JLjoestar23/STM32_FlightController/README.md

# STM32_FlightController
PCB, software, firmware, and other files related to a custom made STM32-based flight controller.
