JLjoestar23/STM32_FlightController/misc/ComponentsBOM.xlsx

Sheet: Electronic Parts
PART NUMBER | PART NAME | DESCRIPTION | QUANTITY | SUPPLIER / MANUFACTURER | UNIT COST | TOTAL PART COST | PURCHASED
C1 | GRM188C71A475KE11D | 4.7uF 0603 SMD Ceramic Capacitor | 10 | https://www.digikey.com/en/products/detail/murata-electronics/GRM188C71A475KE11D/4905309 | $0.1300 | $1.30 | TRUE
C2,C3,C4,C5,C6,C10,C11,C12,C15,C16,C17,C23 | CC0402KRX7R7BB104 | 100nF 0402 SMD Ceramic Capacitor | 60 | https://www.digikey.com/en/products/detail/yageo/CC0402KRX7R7BB104/2103076 | $0.0143 | $0.86 | TRUE
C7 | CC0402KRX7R9BB103 | 10nF 0402 SMD Ceramic Capacitor | 10 | https://www.digikey.com/en/products/detail/yageo/CC0402KRX7R9BB103/2103087 | $0.0090 | $0.09 | TRUE
C8,C9,C18 | CC0402KRX5R5BB105 | 1uF 0402 SMD Ceramic Capacitor | 30 | https://www.digikey.com/en/products/detail/yageo/CC0402KRX5R5BB105/2833603 | $0.0540 | $1.62 | TRUE
C13,C14 | GRM188R71A225KE15J | 2.2uF 0603 SMD Ceramic Capacitor | 20 | https://www.digikey.com/en/products/detail/murata-electronics/GRM188R71A225KE15J/2612462 | $0.0850 | $1.70 | TRUE
C19,C20 | GRM21BC81C226ME44L | 22uF 0805 SMD Ceramic Capacitor | 10 | https://www.digikey.com/en/products/detail/murata-electronics/GRM21BC81C226ME44L/4905510 | $0.2780 | $2.78 | TRUE
C21,C22 | GJM1555C1H140GB01D | 14pF 0402 SMD Ceramic Capacitor | 20 | https://www.digikey.com/en/products/detail/murata-electronics/GJM1555C1H140GB01D/6606072 | $0.0690 | $1.38 | TRUE
D1 | PMEG2005CT,215 | Diode Array/Power Mux | 5 | https://www.digikey.com/en/products/detail/nexperia-usa-inc/PMEG2005CT-215/2119859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 | $0.1050 | $0.53 | TRUE
D2 | LTST-C193KRKT-5A | RED LED | 5 | https://www.digikey.com/en/products/detail/liteon/LTST-C193KRKT-5A/2356244 | $0.1360 | $0.68 | TRUE
FB1 | BLM18PG121SN1D | 100Ω @ 120MHz 0603 SMD Ferrite Bead | 10 | https://www.digikey.com/en/products/detail/murata-electronics/BLM18PG121SN1D/584248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 | $0.0600 | $0.60 | TRUE
J1 | USB Micro-B Wuerth 629105150521 | Micro USB Connector | 2 | https://www.digikey.com/en/products/detail/w%C3%BCrth-elektronik/629105150521/5047751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 | $2.2100 | $4.42 | TRUE
J2 | SM08B-SRSS-TB(LF)(SN) | 1x8 Horizontal SMT JST-SH connector | 2 | https://www.digikey.com/en/products/detail/jst-sales-america-inc/SM08B-SRSS-TB/926714 | $0.7800 | $1.56 | TRUE
J3,J4 | SM04B-SRSS-TB(LF)(SN) | 1x4 Horizontal SMT JST-SH connector | 8 | https://www.chip1stop.com/USA/en/products/J.S.T.-MFG/SM04B-SRSS-TB%28LF%29%28SN%29/JST1*0004445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 | $0.5840 | $4.67 | TRUE
J5 | GRPB052VWVN-RC | 2x5 Vertical 1.27mm Pin Header | 2 | https://www.digikey.com/en/products/detail/sullins-connector-solutions/GRPB052VWVN-RC/1786455 | $0.6100 | $1.22 | TRUE
R1,R6 | RC0402JR-073K3L | 3.3kΩ 0402 SMD Resistor | 20 | https://www.digikey.com/en/products/detail/yageo/RC0402JR-073K3L/726456 | $0.0070 | $0.14 | TRUE
R2,R3,R4,R7 | RC0402FR-072K7L | 2.7kΩ 0402 SMD Resistor | 40 | https://www.digikey.com/en/products/detail/yageo/RC0402FR-072K7L/726556 | $0.0080 | $0.32 | TRUE
R5,R8,R10 | RC0402JR-0710KL | 10kΩ 0402 SMD Resistor | 30 | https://www.digikey.com/en/products/detail/yageo/RC0402JR-0710KL/726418 | $0.0070 | $0.21 | TRUE
R9 | RC0402JR-071K5L | 1.5kΩ 0402 SMD Resistor | 10 | https://www.digikey.com/en/products/detail/yageo/RC0402JR-071K5L/726412 | $0.0070 | $0.07 | TRUE
SW1 | PTS815SJM250SMTRLFS | Tactile Switch Button | 5 | https://www.digikey.com/en/products/detail/c-k/PTS815SJM250SMTRLFS/9947846 | $0.2200 | $1.10 | TRUE
SW2 | PCM12SMTR | Tactile 2 Way Switch | 2 | https://www.digikey.com/en/products/detail/c-k/PCM12SMTR/1640112 | $1.1400 | $2.28 | TRUE
U1,U8 | SN74LVC1T45DBVR | 3.3V - 1.8V Logic Level Shifter | 10 | https://www.digikey.com/en/products/detail/texas-instruments/SN74LVC1T45DBVR/639455 | $0.2910 | $2.91 | TRUE
U2 | ICM-20948 | 9 Axis IMU | 2 | https://www.digikey.com/en/products/detail/tdk-invensense/ICM-20948/6623535 | $6.7800 | $13.56 | TRUE
U3 | STM32F405RGT6 | Microcontroller Unit | 2 | https://www.digikey.com/en/products/detail/stmicroelectronics/STM32F405RGT6/2754208 | $11.1400 | $22.28 | TRUE
U4 | USBLC6-2SC6 | ESD Protection for USB | 5 | https://www.digikey.com/en/products/detail/stmicroelectronics/USBLC6-2SC6/1040559 | $0.3600 | $1.80 | TRUE
U5 | AMS1117-3.3 | 5V - 3.3V Low-Dropout Regulator | 5 | https://www.digikey.com/en/products/detail/evvo/AMS1117-3-3/22482148 | $0.2700 | $1.35 | TRUE
U6 | TLV70018 | 3.3V - 1.8V Low-Dropout Regulator | 5 | https://www.digikey.com/en/products/detail/texas-instruments/TLV70018DDCR/2232568 | $0.2000 | $1.00 | TRUE
U7 | BMP390 | Barometric Pressure Sensor | 2 | https://www.digikey.com/en/products/detail/bosch-sensortec/BMP390/16164575 | $3.1500 | $6.30 | TRUE
Y1 | X32258MOB4SI | 8MHz Crystal | 5 | https://lcsc.com/product-detail/Crystals_Yangxing-Tech-X32258MOB4SI_C2682775.html | $0.1649 | $0.82 | TRUE
 |  | TOTAL PARTS | 337 |  | TOTAL | $77.55

Sheet: General BOM
PART NAME | DESCRIPTION | QUANTITY | SUPPLIER / MANUFACTURER | UNIT COST | TOTAL PART COST | PURCHASED
RP1 V2 ExpressLRS 2.4ghz Nano Receiver | ELRS Receiver | 1 | https://www.radiomasterrc.com/products/rp1-expresslrs-2-4ghz-nano-receiver?variant=46464159908071 | $18.99 | $18.99 | FALSE
XRotor FPV 30x30 ESC 65A | 4 in 1 ESC | 1 | https://www.hobbywingdirect.com/collections/xrotor-fpv-30x30-esc/products/xrotor-fpv-30x30-esc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 | $99.99 | $99.99 | FALSE
Mark 4 7inch 295mm 2807 1300KV Brushless Motor 7040 Propeller for Mark4 FPV Racing Drone Quadcopter Freestyle Frame Kit | 7" Drone Frame Kit | 1 | https://www.aliexpress.us/item/3256808893088782.html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 | $29.89 | $29.89 | FALSE
8pcs HQProp 7X3.5X3 7 Inch 3-Blade Propellers Set (4X CW / 4X CCW) Poly Carbonate | Propellors | 1 | https://www.amazon.com/HQProp-7X3-5X3-3-Blade-Propellers-Carbonate/dp/B0CTY33T4G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 | $19.99 | $19.99 | FALSE
Boxer Radio Controller (M2) | Radio Transmitter | 1 | https://www.radiomasterrc.com/collections/transmitter/products/boxer-radio-controller-m2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 | $139.99 | $139.99 | FALSE
 |  |  |  |  | $0.00 | FALSE
 |  |  |  |  | $0.00 | FALSE
 |  |  |  |  | $0.00 | FALSE
 |  |  |  |  | $0.00 | FALSE
 |  |  |  |  | $0.00 | FALSE
 |  |  |  |  | $0.00 | FALSE
 |  |  |  |  | $0.00 | FALSE
 |  |  |  |  | $0.00 | FALSE
 |  |  |  |  | $0.00 | FALSE
 |  |  |  |  | $0.00 | FALSE
 |  |  |  |  | $0.00 | FALSE
 |  |  |  |  | $0.00 | FALSE
 |  |  |  |  | $0.00 | FALSE
 |  |  |  |  | $0.00 | FALSE
 |  |  |  |  | $0.00 | FALSE
 |  |  |  |  | $0.00 | FALSE
 |  |  |  |  | $0.00 | FALSE
 |  |  |  |  | $0.00 | FALSE
 |  |  |  |  | $0.00 | FALSE
 |  |  |  |  | $0.00 | FALSE
 |  |  |  |  | $0.00 | FALSE
 |  |  |  |  | $0.00 | FALSE
 |  |  |  |  | $0.00 | FALSE
 | TOTAL PARTS | 5 |  | TOTAL | $308.85
