JLjoestar23/STM32_FlightController/misc/various_handcalcs.xlsx

Sheet: Current Draw Calcs
Component | Typical Current Draw (mA) | Total Current Draw (mA) | Buffer
STM32F405RGT6 + Peripherals | 120 | 225 | 25%
BMP390 | 1
ICM 20948 | 4 | Total Current Draw w/ Buffer
Adafruit Ultimate GPS Breakout | 20 | 281.25
RP1 Receiver | 80

Sheet: Impedance Matching
Geomtery:
w
d
t
h
