JLjoestar23/STM32_FlightController/STM32_FlightController_Rev2/Footprints-Symbols-Models/BMP390L/BMP390L.step

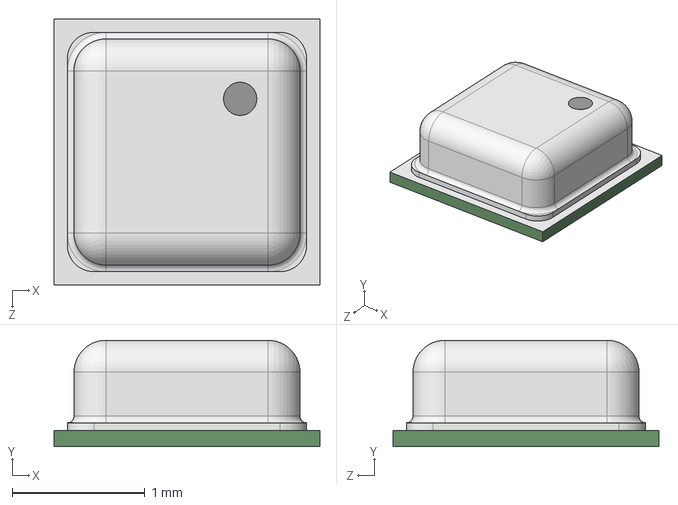
[picture p1: CAD file, 2025-05-25]
STM32_FlightController_Rev2/Footprints-Symbols-Models/BMP390L/BMP390L.step
2.00 x 0.8 x 2.00 mm
