JLjoestar23/STM32_FlightController/STM32_FlightController_Rev2/Footprints-Symbols-Models/SM04B-SRSS-TB.STEP

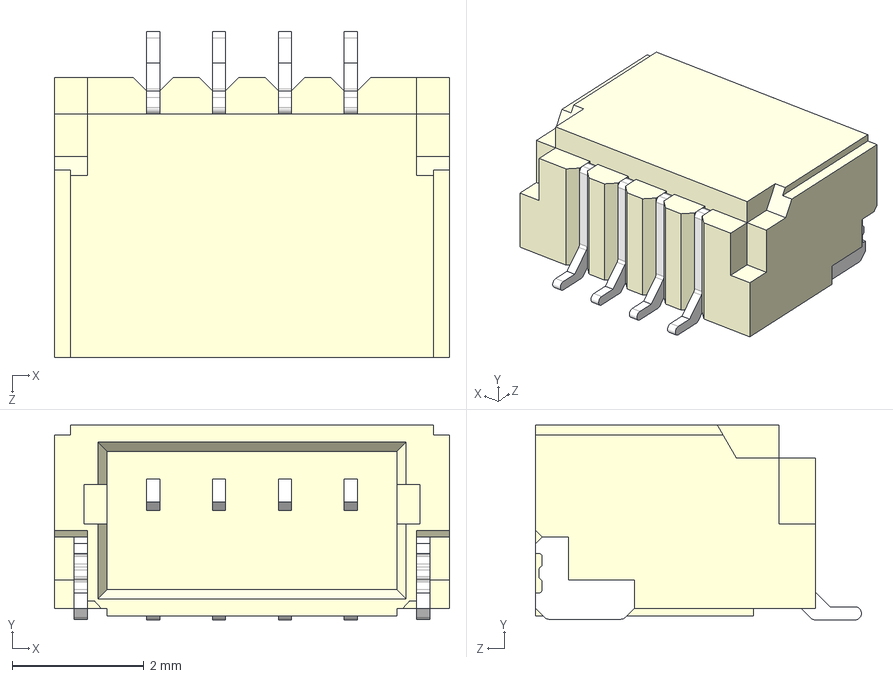
[picture p2: CAD file, 2025-06-05]
STM32_FlightController_Rev2/Footprints-Symbols-Models/SM04B-SRSS-TB.STEP
6.00 x 2.96 x 4.95 mm
