JLjoestar23/STM32_FlightController/STM32_FlightController_Rev2/Footprints-Symbols-Models/SM08B-SRSS-TB.step

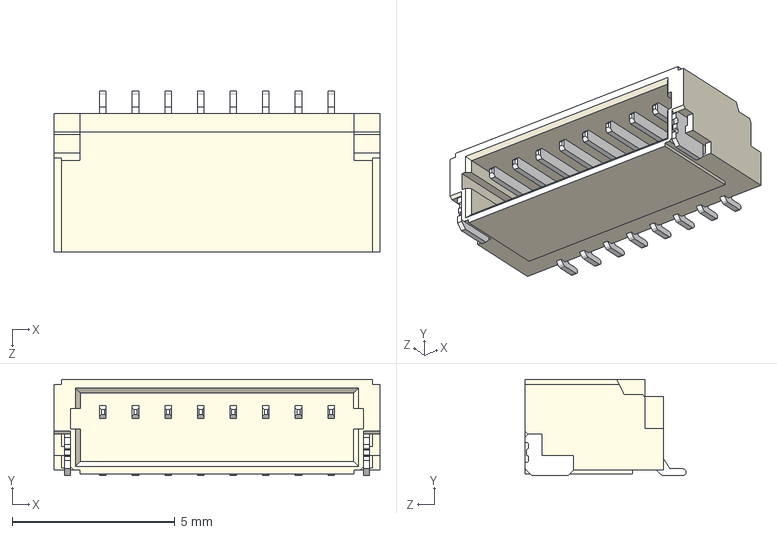
[picture p3: CAD file, 2025-06-05]
STM32_FlightController_Rev2/Footprints-Symbols-Models/SM08B-SRSS-TB.step
10.00 x 2.95 x 4.95 mm
