JLjoestar23/STM32_FlightController/STM32_FlightController_Rev2/Footprints-Symbols-Models/PTS815SJG250SMTRLFS.stp

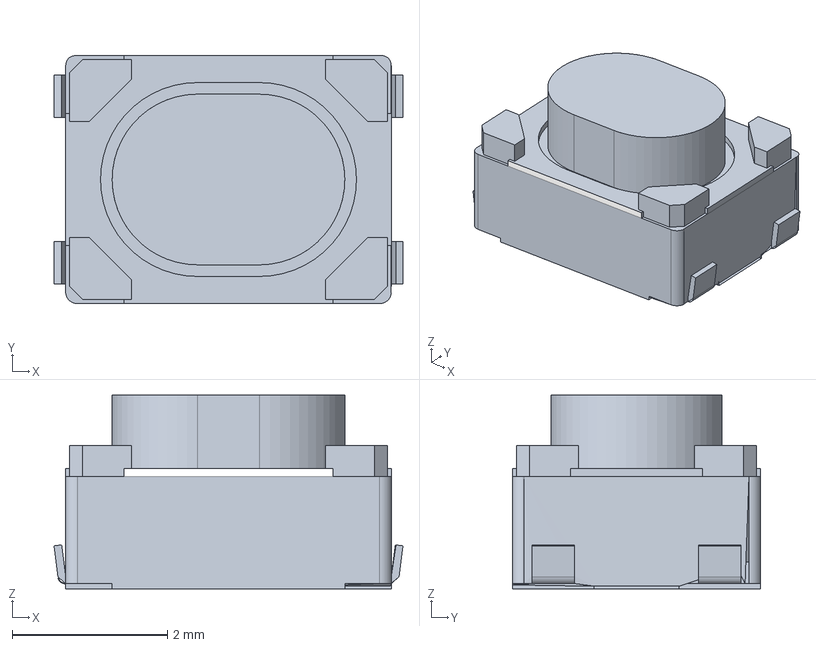
[picture p4: CAD file, 2025-05-25]
STM32_FlightController_Rev2/Footprints-Symbols-Models/PTS815SJG250SMTRLFS.stp
4.50 x 3.20 x 2.50 mm
PTS815SJG250SMTRLFS_PART1
PTS815SJG250SMTRLFS_PART2
PTS815SJG250SMTRLFS_PART3
