JLjoestar23/STM32_FlightController/STM32_FlightController_Rev2/Footprints-Symbols-Models/ICM-20948--3DModel-STEP-269445.STEP

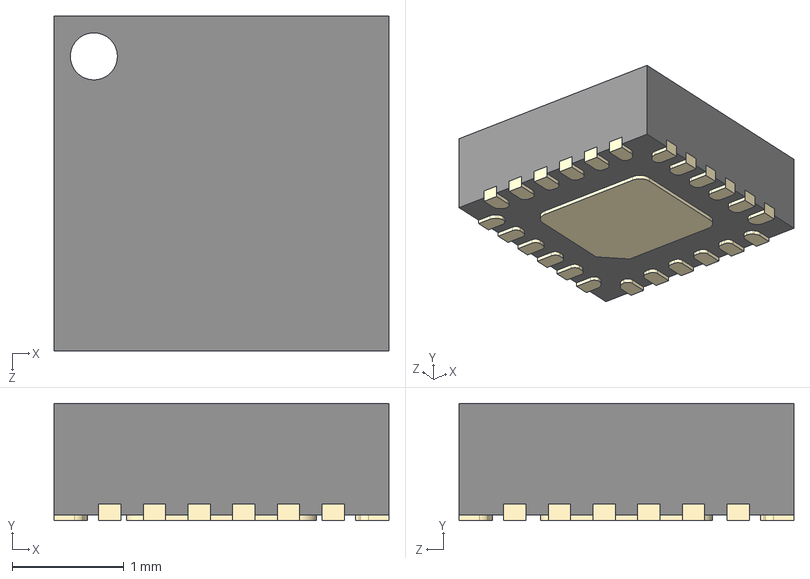
[picture p5: CAD file, 2025-05-25]
STM32_FlightController_Rev2/Footprints-Symbols-Models/ICM-20948--3DModel-STEP-269445.STEP
3.00 x 1.05 x 3.00 mm
