JLjoestar23/STM32_FlightController/STM32_FlightController_Rev2/Footprints-Symbols-Models/629105150521_20_28rev1_29.stp

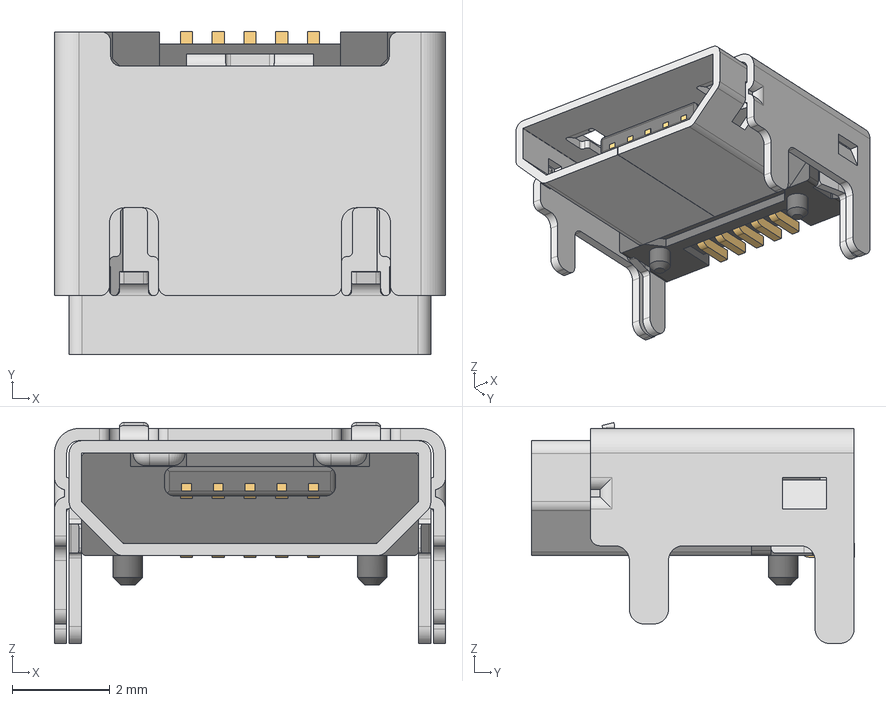
[picture p6: CAD file, 2025-06-05]
STM32_FlightController_Rev2/Footprints-Symbols-Models/629105150521_20_28rev1_29.stp
8.00 x 6.60 x 4.52 mm
629105150521_Housing
629105150521_Pin1 x 4
629105150521_Pin2
629105150521_Shielding2
629105150521_Shielding
