JLjoestar23/STM32_FlightController/STM32_FlightController_Rev2/STM32_FlightController.kicad_pcb

## KiCad design STM32_FlightController_Rev2/STM32_FlightController.kicad_pcb (2025-07-28)

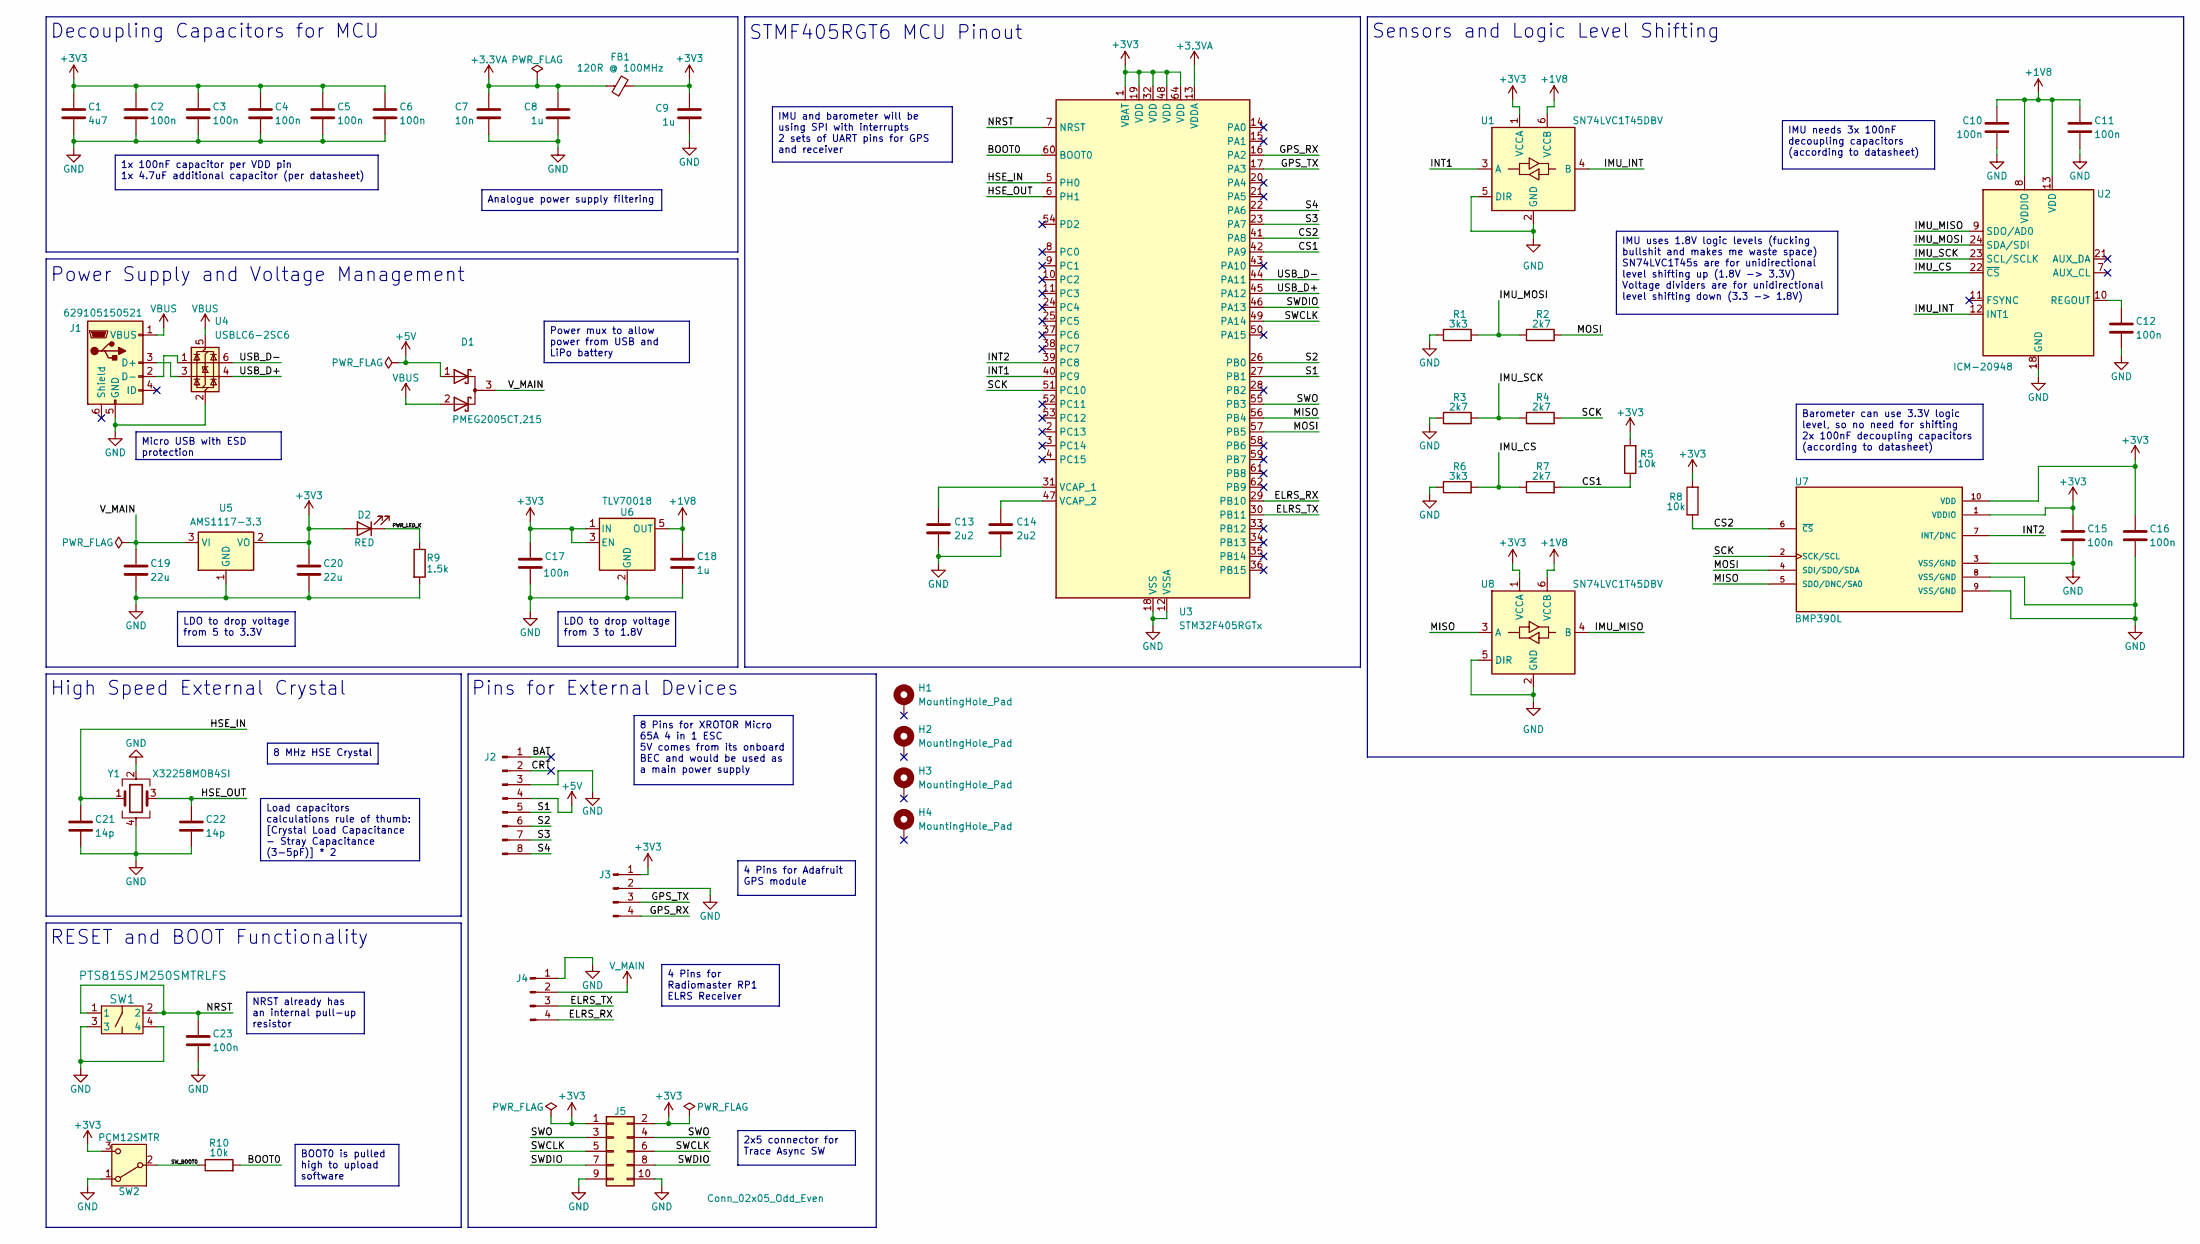
[picture p7: schematic STM32_FlightController.kicad_sch]

Parts:
C1: 4u7; C_0603_1608Metric
C2, C3, C4, C5, C6, C10, C11, C12, C15, C16, C23: 100n; C_0402_1005Metric
C7: 10n; C_0402_1005Metric
C8, C9: 1u; C_0402_1005Metric
C13, C14: 2u2; C_0603_1608Metric
C17: 100n; C_0603_1608Metric
C18: 1u; C_0603_1608Metric
C19, C20: 22u; C_0805_2012Metric
C21, C22: 14p; C_0402_1005Metric
D1: PMEG2005CT,215; SOT-23
D2: RED; LED_0603_1608Metric
FB1: 120R @ 100MHz; L_0603_1608Metric
H1, H2, H3, H4: MountingHole_Pad; MountingHole_4mm_Pad
J1: 629105150521; USB_Micro-B_Wuerth_629105150521
J2: JST_SH_SM08B-SRSS-TB_1x08-1MP_P1.00mm_Horizontal
J3, J4: JST_SH_SM04B-SRSS-TB_1x04-1MP_P1.00mm_Horizontal
J5: Conn_02x05_Odd_Even; PinHeader_2x05_P1.27mm_Vertical
R1, R6: 3k3; R_0402_1005Metric
R2, R3, R4, R7: 2k7; R_0402_1005Metric
R5, R8, R10: 10k; R_0402_1005Metric
R9: 1.5k; R_0402_1005Metric
SW1: PTS815SJM250SMTRLFS; SW4_PTS815 SJM 250 SMTR LFS_CNK
SW2: PCM12SMTR; SW_SPDT_PCM12
U1, U8: SN74LVC1T45DBV; SOT-23-6
U2: ICM-20948; InvenSense_QFN-24_3x3mm_P0.4mm
U3: STM32F405RGTx; LQFP-64_10x10mm_P0.5mm
U4: USBLC6-2SC6; SOT-23-6
U5: AMS1117-3.3; SOT-223-3_TabPin2
U6: TLV70018; SOT-23-5
U7: BMP390L; PARTREV 1.7
Y1: X32258MOB4SI; Crystal_SMD_3225-4Pin_3.2x2.5mm

Connections:
+1V8: C10.1, C11.1, C18.1, U1.6 (VCCB), U2.8 (VDDIO), U2.13 (VDD), U6.5 (OUT), U8.6 (VCCB)
+3.3VA: C7.1, C8.1, FB1.1, U3.13 (VDDA)
+3V3: C1.1, C2.1, C3.1, C4.1, C5.1, C6.1, C9.1, C15.1, C16.1, C17.1, C20.1, D2.2 (A), FB1.2, J3.1, J5.1, J5.2, R5.2, R8.2, SW2.3 (C), U1.1 (VCCA), U3.1 (VBAT), U3.19 (VDD), U3.32 (VDD), U3.48 (VDD), U3.64 (VDD), U5.2 (VO), U6.1 (IN), U6.3 (EN), U7.1 (VDDIO), U7.10 (VDD), U8.1 (VCCA)
+5V: D1.1 (A), J2.4
/BAT: J2.1
/BOOT0: R10.2, U3.60 (BOOT0)
/CRT: J2.2
/CS1: R5.1, R7.2, U3.42 (PA9)
/CS2: R8.1, U3.41 (PA8), U7.6 (~CS)
/ELRS_RX: J4.4, U3.29 (PB10)
/ELRS_TX: J4.3, U3.30 (PB11)
/GPS_RX: J3.4, U3.16 (PA2)
/GPS_TX: J3.3, U3.17 (PA3)
/HSE_IN: C21.1, U3.5 (PH0), Y1.1
/HSE_OUT: C22.1, U3.6 (PH1), Y1.3
/IMU_CS: R6.2, R7.1, U2.22 (~CS)
/IMU_INT: U1.4 (B), U2.12 (INT1)
/IMU_MISO: U2.9 (SDO/AD0), U8.4 (B)
/IMU_MOSI: R1.2, R2.1, U2.24 (SDA/SDI)
/IMU_SCK: R3.2, R4.1, U2.23 (SCL/SCLK)
/INT1: U1.3 (A), U3.40 (PC9)
/INT2: U3.39 (PC8), U7.7 (INT/DNC)
/MISO: U3.56 (PB4), U7.5 (SDO/DNC/SA0), U8.3 (A)
/MOSI: R2.2, U3.57 (PB5), U7.4 (SDI/SDO/SDA)
/NRST: C23.1, SW1.1, SW1.2, U3.7 (NRST)
/PWR_LED_K: D2.1 (K), R9.1
/S1: J2.5, U3.27 (PB1)
/S2: J2.6, U3.26 (PB0)
/S3: J2.7, U3.23 (PA7)
/S4: J2.8, U3.22 (PA6)
/SCK: R4.2, U3.51 (PC10), U7.2 (SCK/SCL)
/SWCLK: J5.5, J5.6, U3.49 (PA14)
/SWDIO: J5.7, J5.8, U3.46 (PA13)
/SWO: J5.3, J5.4, U3.55 (PB3)
/SW_BOOT0: R10.1, SW2.2 (B)
/USB_D+: U3.45 (PA12), U4.4 (I/O2)
/USB_D-: U3.44 (PA11), U4.6 (I/O1)
GND: C1.2, C2.2, C3.2, C4.2, C5.2, C6.2, C7.2, C8.2, C9.2, C10.2, C11.2, C12.2, C13.2, C14.2, C15.2, C16.2, C17.2, C18.2, C19.2, C20.2, C21.2, C22.2, C23.2, J1.5 (GND), J2.3, J3.2, J4.1, J5.9, J5.10, R1.1, R3.1, R6.1, R9.2, SW1.3, SW1.4, SW2.1 (A), U1.2 (GND), U1.5 (DIR), U2.18 (GND), U2.20 (GND), U3.12 (VSSA), U3.18 (VSS), U3.63 (VSS), U4.2 (GND), U5.1 (GND), U6.2 (GND), U7.3 (VSS/GND), U7.8 (VSS/GND), U7.9 (VSS/GND), U8.2 (GND), U8.5 (DIR), Y1.2, Y1.4
unnamed: J1.3 (D+), U4.3 (I/O2)
unnamed: J1.2 (D-), U4.1 (I/O1)
unnamed: C12.1, U2.10 (REGOUT)
unnamed: C13.1, U3.31 (VCAP_1)
unnamed: C14.1, U3.47 (VCAP_2)
VBUS: D1.2 (A), J1.1 (VBUS), U4.5 (VBUS)
V_MAIN: C19.1, D1.3 (K), J4.2, U5.3 (VI)

Notes on the sheet:
Pins for External Devices
STMF405RGT6 MCU Pinout
High Speed External Crystal
Power Supply and Voltage Management
RESET and BOOT Functionality
Decoupling Capacitors for MCU
Sensors and Logic Level Shifting
4 Pins for Radiomaster RP1 ELRS Receiver
NRST already has an internal pull-up resistor
4 Pins for Adafruit GPS module
IMU needs 3x 100nF decoupling capacitors (according to datasheet)
Power mux to allow power from USB and LiPo battery
Barometer can use 3.3V logic level, so no need for shifting 2x 100nF decoupling capacitors (according to datasheet)
LDO to drop voltage from 5 to 3.3V
Load capacitors calculations rule of thumb: [Crystal Load Capacitance - Stray Capacitance (3-5pF)] * 2
BOOT0 is pulled high to upload software
LDO to drop voltage from 3 to 1.8V
IMU and barometer will be using SPI with interrupts 2 sets of UART pins for GPS and receiver
8 MHz HSE Crystal
8 Pins for XROTOR Micro 65A 4 in 1 ESC 5V comes from its onboard BEC and would be used as a main power supply
1x 100nF capacitor per VDD pin 1x 4.7uF additional capacitor (per datasheet)
2x5 connector for Trace Async SW
IMU uses 1.8V logic levels (fucking bullshit and makes me waste space) SN74LVC1T45s are for unidirectional level shifting up (1.8V -> 3.3V) Voltage dividers are for unidirectional level shifting down (3.3 -> 1.8V)
Micro USB with ESD protection
Analogue power supply filtering

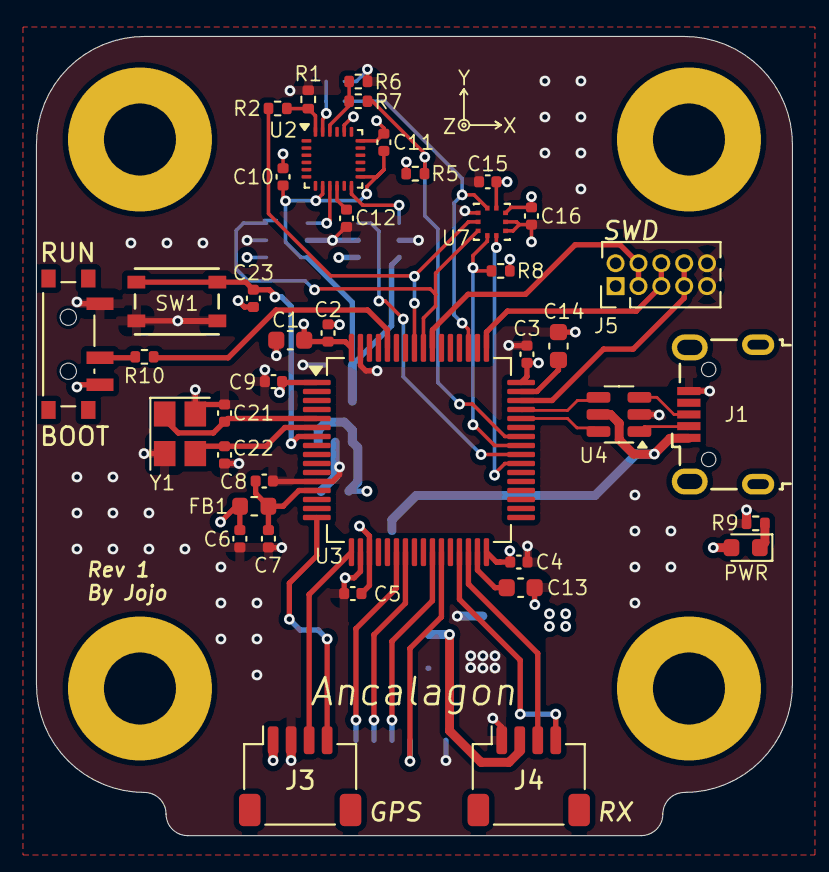
[picture p8: board STM32_FlightController.kicad_pcb from above]

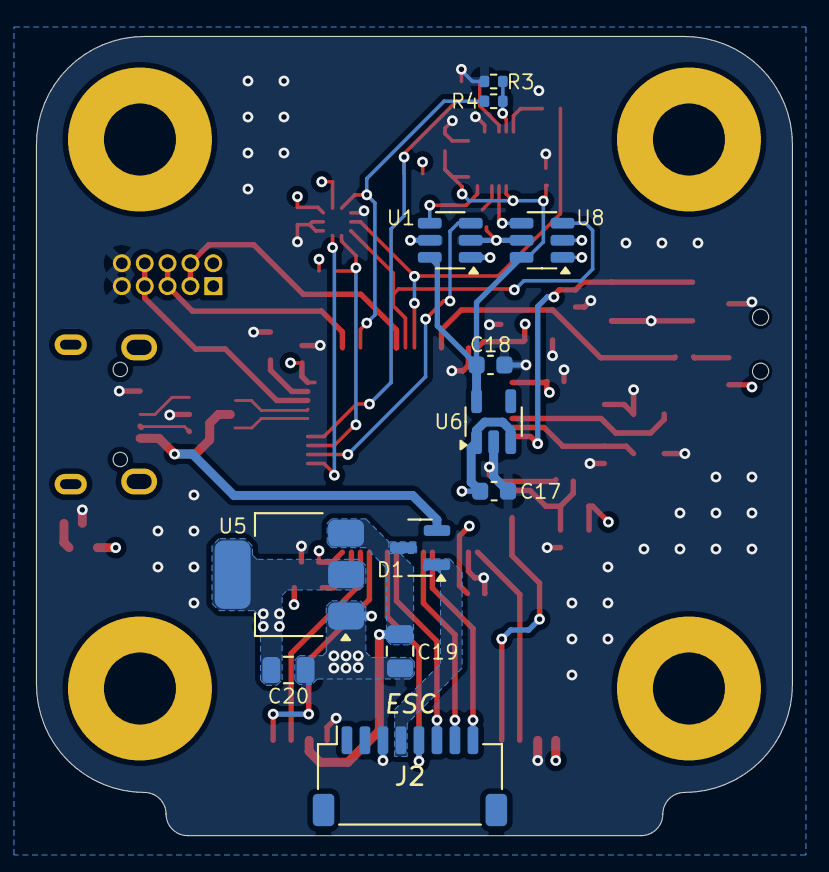
[picture p9: board STM32_FlightController.kicad_pcb from below]

Board: 4 copper layers, 42.0 x 44.4 mm, 56 parts (12 on the bottom side), 43 nets.
