JLjoestar23/STM32_FlightController/Firmware+Software/Core/Inc/main.h

#define USART2_TX_Pin GPIO_PIN_2
#define USART2_TX_GPIO_Port GPIOA
#define USART2_RX_Pin GPIO_PIN_3
#define USART2_RX_GPIO_Port GPIOA
#define USART3_TX_Pin GPIO_PIN_10
#define USART3_TX_GPIO_Port GPIOB
#define USART3_RX_Pin GPIO_PIN_11
#define USART3_RX_GPIO_Port GPIOB
#define INT2_Pin GPIO_PIN_8
#define INT2_GPIO_Port GPIOC
#define INT1_Pin GPIO_PIN_9
#define INT1_GPIO_Port GPIOC
#define NCS2_Pin GPIO_PIN_8
#define NCS2_GPIO_Port GPIOA
#define NCS1_Pin GPIO_PIN_9
#define NCS1_GPIO_Port GPIOA
