JLjoestar23/STM32_FlightController/Firmware+Software/Core/Inc/spi.h

#ifndef INC_SPI_H_
#define INC_SPI_H_

#include "stdint.h"
#include "stm32f4xx.h"

typedef enum {
	ICM20948_NCS = 0,
	BMP390_NCS = 1
} peripheral_select;

typedef enum {
	SPI_OK       = 0x00U,
	SPI_ERROR    = 0x01U,
	SPI_BUSY     = 0x02U,
	SPI_TIMEOUT  = 0x03U
} SPI_status;

void SPI_pins_init();

void NCS_pins_init();

void SPI_configure();

void SPI_transmit(uint8_t *Txdata, uint32_t size);

void SPI_receive(uint8_t *Rxdata, uint32_t size);

void SPI_transmit_receive(uint8_t *Txdata, uint8_t *Rxdata, uint32_t size);

void peripheral_select(peripheral_select peripheral);

void peripheral_deselect(peripheral_select peripheral);

#endif /* INC_SPI_H_ */
