JLjoestar23/STM32_FlightController/(commit log)

2025-05-25 initial commit of PCB related files
    [BMP390L.step, ICM-20948--3DModel-STEP-269445.STEP, PTS815SJG250SMTRLFS.stp, STM32_FlightController.kicad_pcb, STM32_FlightController.kicad_sch]
2025-05-28 added firmware framework, some PCB modifications
    [STM32_FlightController.kicad_pcb, STM32_FlightController.kicad_sch]
2025-05-28 routing and layout changes
    [STM32_FlightController.kicad_pcb]
2025-05-28 corrected BMP390 schematic wiring and layout, among other corrections
    [STM32_FlightController.kicad_pcb, STM32_FlightController.kicad_sch]
2025-05-28 fixed respective RX and TX wirings
    [STM32_FlightController.kicad_pcb, STM32_FlightController.kicad_sch]
2025-05-29 correcting majority of via placements
    [STM32_FlightController.kicad_pcb]
2025-05-31 suggested fixes
    [STM32_FlightController.kicad_pcb, STM32_FlightController.kicad_sch]
2025-06-01 re-speccing the power mux to PMEG2005CT,215 rated for 500 mA
    [STM32_FlightController.kicad_pcb, STM32_FlightController.kicad_sch]
2025-06-03 replaced transistors with level shifter ICs
    transistors appeared to switch to slowly for SPI, ICs seemed like they would be fast enough
    required significant rerouting of SPI traces from sensors
    [STM32_FlightController.kicad_pcb, STM32_FlightController.kicad_sch]
2025-06-04 90 ohm impedance matching for USB traces
    [STM32_FlightController.kicad_pcb]
2025-06-05 replaced pads with corresponding JST-SH connectors
    [629105150521_20_28rev1_29.stp, SM04B-SRSS-TB.STEP, SM08B-SRSS-TB.step, STM32_FlightController.kicad_pcb, STM32_FlightController.kicad_sch]
2025-06-05 adjusted mounting hole positions to 30.5mm apart
    [STM32_FlightController.kicad_pcb]
2025-06-06 various minor adjustments for positioning
    [STM32_FlightController.kicad_pcb, various_handcalcs.xlsx]
2025-06-09 finalizing components, adjusting some positioning
    [STM32_FlightController.kicad_pcb, STM32_FlightController.kicad_sch]
2025-06-09 replaced mounting holes with padded ones
    [STM32_FlightController.kicad_pcb, STM32_FlightController.kicad_sch]
2025-06-09 minor positioning changes
    [STM32_FlightController.kicad_pcb, STM32_FlightController.kicad_sch]
2025-06-10 cubeIDE code generation/setup
    [STM32_FlightController.kicad_pcb, STM32_FlightController.kicad_sch]
2025-06-10 swapped 5V and GND on the ELRS receiver connector
    [STM32_FlightController.kicad_pcb, STM32_FlightController.kicad_sch]
2025-06-10 added top, bottom ground planes w/ stitching
    [STM32_FlightController.kicad_pcb]
2025-06-10 final edits, passed DRC
    [STM32_FlightController.kicad_pcb]
2025-06-11 added manufacturing related files
    [STM32_CPL.xlsx, STM32_FlightController-B_Cu.gbr, STM32_FlightController-B_Mask.gbr, STM32_FlightController-B_Paste.gbr, STM32_FlightController-B_Silkscreen.gbr, STM32_FlightController-Edge_Cuts.gbr, STM32_FlightController-F_Cu.gbr, STM32_FlightController-F_Mask.gbr]
2025-06-12 added general BOM
    [ComponentsBOM.xlsx, STM32_FlightController_BOM.csv]
2025-06-12 added some draw rule areas for GND planes
    [STM32_FlightController.kicad_pcb]
2025-06-13 aesthetics changes
    [STM32_FlightController-B_Cu.gbr, STM32_FlightController-B_Mask.gbr, STM32_FlightController-B_Paste.gbr, STM32_FlightController-B_Silkscreen.gbr, STM32_FlightController-Edge_Cuts.gbr, STM32_FlightController-F_Cu.gbr, STM32_FlightController-F_Mask.gbr, STM32_FlightController-F_Paste.gbr]
2025-06-13 re-did manufacturing files
    [STM32_CPL.xlsx, STM32_FlightController-B_Cu.gbr, STM32_FlightController-B_Mask.gbr, STM32_FlightController-B_Paste.gbr, STM32_FlightController-B_Silkscreen.gbr, STM32_FlightController-Edge_Cuts.gbr, STM32_FlightController-F_Cu.gbr, STM32_FlightController-F_Mask.gbr]
2025-06-13 still trying to resolve merge conflict
    [STM32_CPL.xlsx, STM32_FlightController-B_Cu.gbr, STM32_FlightController-B_Mask.gbr, STM32_FlightController-B_Paste.gbr, STM32_FlightController-B_Silkscreen.gbr, STM32_FlightController-Edge_Cuts.gbr, STM32_FlightController-F_Cu.gbr, STM32_FlightController-F_Mask.gbr]
2025-06-13 re-organizing manufacturing related files
    [STM32_CPL.xlsx, STM32_FlightController-B_Cu.gbr, STM32_FlightController-B_Mask.gbr, STM32_FlightController-B_Paste.gbr, STM32_FlightController-B_Silkscreen.gbr, STM32_FlightController-Edge_Cuts.gbr, STM32_FlightController-F_Cu.gbr, STM32_FlightController-F_Mask.gbr]
2025-06-13 more re-organization
    [629105150521_20_28rev1_29.stp, BMP390L.step, ICM-20948--3DModel-STEP-269445.STEP, PTS815SJG250SMTRLFS.stp, SM04B-SRSS-TB.STEP, SM08B-SRSS-TB.step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]
2025-06-15 added manufacturing stencils, some more organization
    [STM32_CPL.xlsx, STM32_FlightController-B_Cu.gbr, STM32_FlightController-B_Mask.gbr, STM32_FlightController-B_Paste.gbr, STM32_FlightController-B_Silkscreen.gbr, STM32_FlightController-Edge_Cuts.gbr, STM32_FlightController-F_Cu.gbr, STM32_FlightController-F_Mask.gbr]
2025-06-15 updated BOM
    [ComponentsBOM.xlsx]
2025-06-15 began development of SPI driver
2025-06-17 further SPI driver development
    [STM32_FlightController.kicad_pcb]
2025-06-17 creating SPI simultaneous read-write function
2025-06-17 polishing SPI driver code
2025-06-17 minor SPI changes
2025-06-22 developing IMU drivers
2025-07-08 further development to IMU driver
2025-07-25 started development of IMU calibration functionality
2025-07-26 implemented gyroscope calibration function
2025-07-27 implemented accel calibration function
2025-07-28 correct PCB traces regarding TIM pins
    [STM32_FlightController-B_Cu.gbr, STM32_FlightController-B_Mask.gbr, STM32_FlightController-B_Paste.gbr, STM32_FlightController-B_Silkscreen.gbr, STM32_FlightController-Edge_Cuts.gbr, STM32_FlightController-F_Cu.gbr, STM32_FlightController-F_Mask.gbr, STM32_FlightController-F_Paste.gbr]
2025-07-28 remade the manufacturing folder
    [STM32_FlightController.kicad_pcb]
2025-07-29 corrections to the IMU driver header file
    [icm20948.h]
2025-07-29 added missing read/write compass function definitions
    [icm20948.h]
2025-07-29 implemented IMU driver using SPI HAL as an alternative
2025-07-30 fixed incorrect usage of pointers in IMU read/write functions
    [icm20948.c, icm20948.h]
2025-08-06 configured USART3 for DMA
