JLjoestar23/STM32_FlightController/(notices)

Notices in the files:
Firmware+Software/Core/Inc/main.h:
Copyright (c) 2025 STMicroelectronics.
All rights reserved.
This software is licensed under terms that can be found in the LICENSE file
STM32_FlightController_Rev2/Footprints-Symbols-Models/PTS815SJG250SMTRLFS.stp:
author */ ('License CC BY-ND 4.0'),
